vibr77/AppleIISDiskII_stm32f401/photo_screen/processed-6421B9E4-818E-487C-A50D-6F0CE80E2289.jpeg

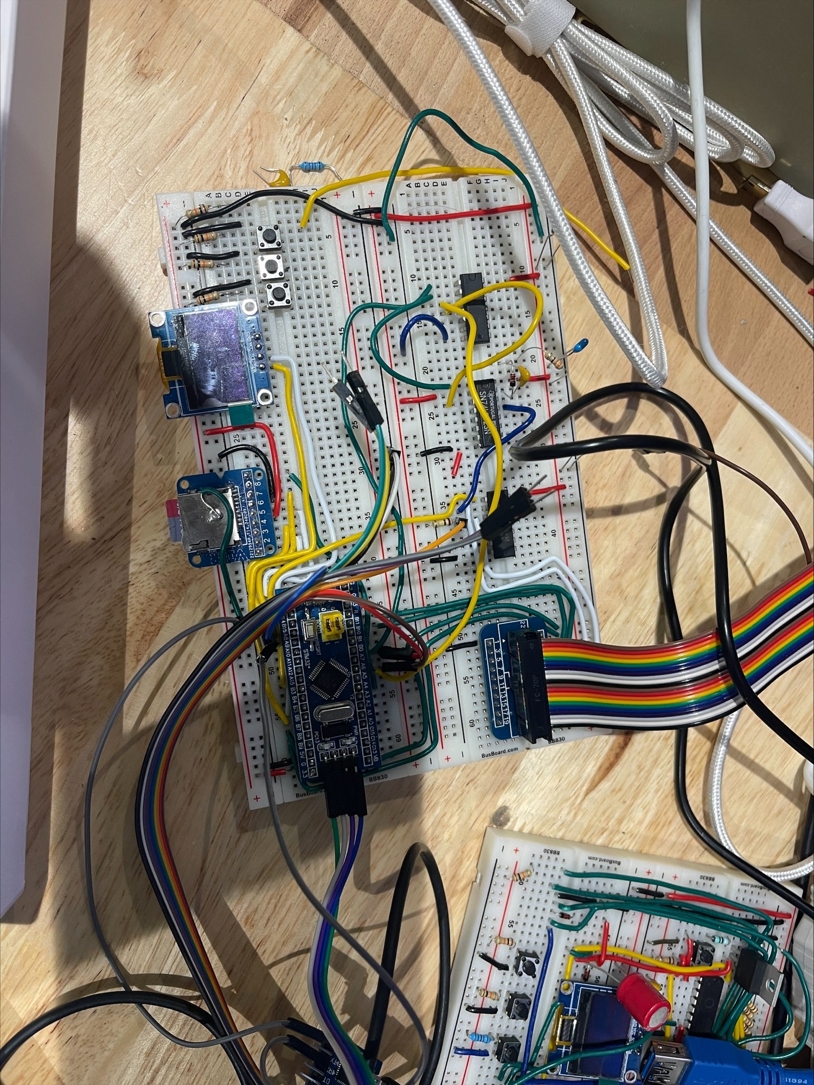
photo_screen/processed-6421B9E4-818E-487C-A50D-6F0CE80E2289.jpeg
