vibr77/AppleIISDiskII_stm32f401/photo_screen/processed-DC6E5C40-3600-4D25-BB47-7D1686A29BE4.jpeg

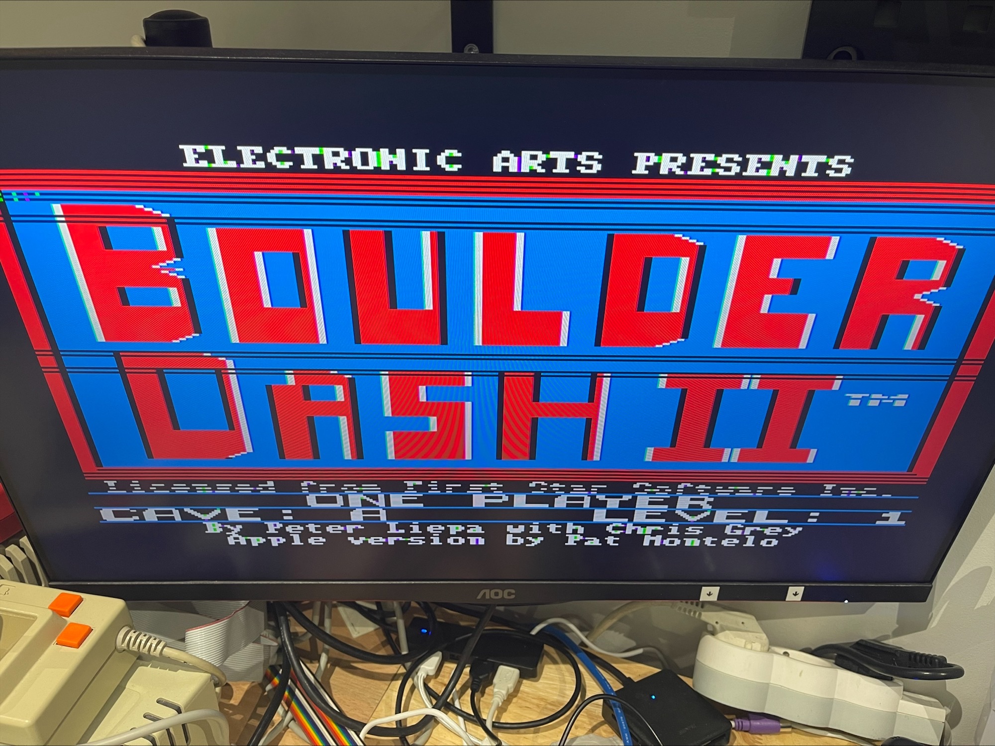
photo_screen/processed-DC6E5C40-3600-4D25-BB47-7D1686A29BE4.jpeg
