vibr77/AppleIISDiskII_stm32f401/screenshot/IMG_6480 Large.jpeg

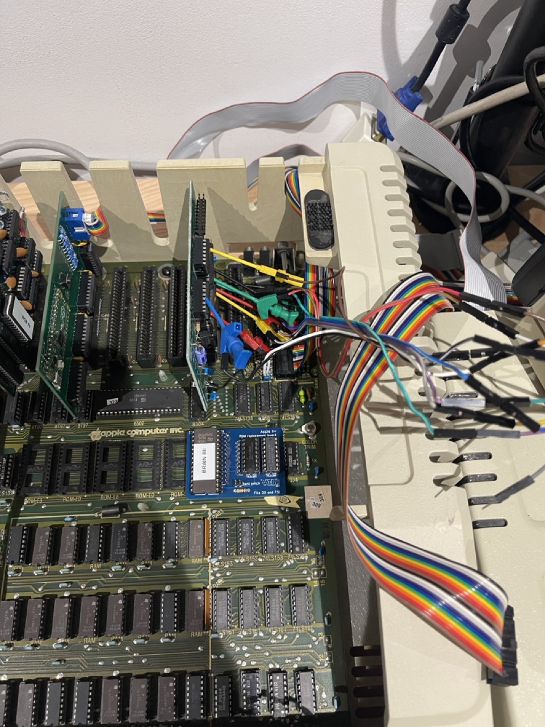
screenshot/IMG_6480 Large.jpeg
