vibr77/AppleIISDiskII_stm32f401/hardware/sdiskII_stm32.kicad_sch

## KiCad design hardware/sdiskII_stm32.kicad_sch (2024-07-04)

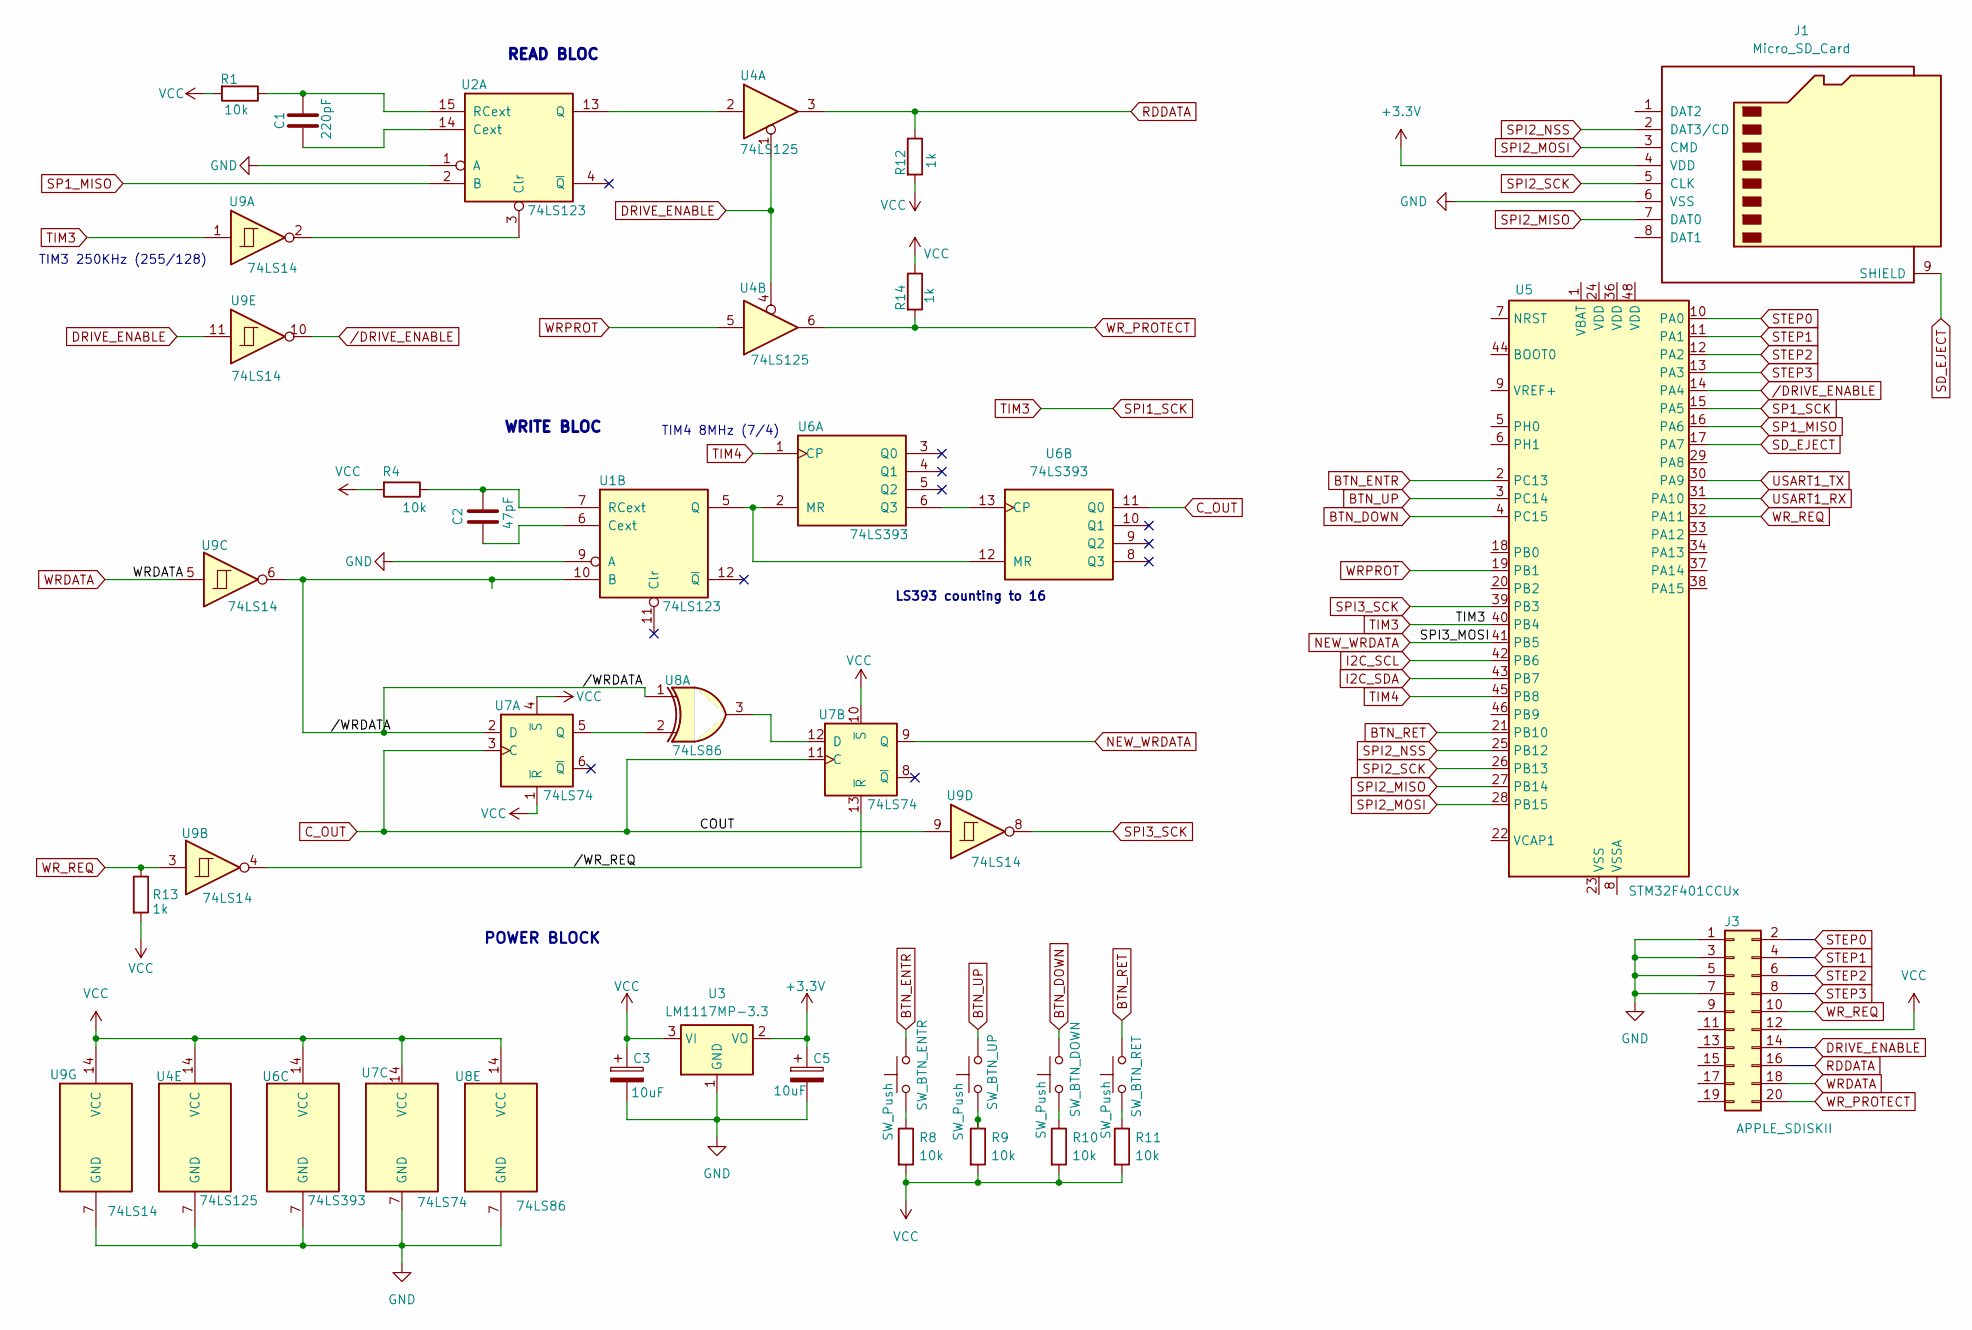
[picture p5: schematic sdiskII_stm32.kicad_sch]

Parts:
C1: 220pF
C2: 47pF
C3, C5: 10uF
J1: Micro_SD_Card
J3: APPLE_SDISKII
R1, R4, R8, R9, R10, R11: 10k
R12, R13, R14: 1k
SW_BTN_DOWN: SW_Push
SW_BTN_ENTR: SW_Push
SW_BTN_RET: SW_Push
SW_BTN_UP: SW_Push
U1, U2: 74LS123
U3: LM1117MP-3.3; SOT-223-3_TabPin2
U4: 74LS125
U5: STM32F401CCUx; QFN-48-1EP_7x7mm_P0.5mm_EP5.6x5.6mm
U6: 74LS393
U7: 74LS74
U8: 74LS86
U9: 74LS14

Connections:
+3.3V: C5.1, J1.4 (VDD), U3.2 (VO)
BTN_DOWN: SW_BTN_DOWN.2, U5.4 (PC15)
BTN_ENTR: SW_BTN_ENTR.2, U5.2 (PC13)
BTN_RET: SW_BTN_RET.2, U5.21 (PB10)
BTN_UP: SW_BTN_UP.2, U5.3 (PC14)
C_OUT: U6.11 (Q0), U7.3 (C), U7.11 (C), U9.9
DRIVE_ENABLE: U4.1, U4.4, U9.11
GND: C3.2, C5.2, J1.6 (VSS), J3.1, J3.3, J3.5, J3.7, U1.9 (A), U2.1 (A), U3.1 (GND), U4.7 (GND), U6.7 (GND), U7.7 (GND), U8.7 (GND), U9.7 (GND)
I2C_SCL: U5.42 (PB6)
I2C_SDA: U5.43 (PB7)
NEW_WRDATA: U5.41 (PB5), U7.9 (Q)
unnamed: C1.1, R1.1, U2.15 (RCext)
unnamed: C1.2, U2.14 (Cext)
unnamed: C2.1, U1.6 (Cext)
unnamed: C2.2, R4.1, U1.7 (RCext)
unnamed: R8.1, SW_BTN_ENTR.1
unnamed: R9.1, SW_BTN_UP.1
unnamed: R10.1, SW_BTN_DOWN.1
unnamed: R11.1, SW_BTN_RET.1
unnamed: U1.5 (Q), U6.2 (MR), U6.12 (MR)
unnamed: U2.3 (Clr), U9.2
unnamed: U2.13 (Q), U4.2
unnamed: U5.23 (VSS), U5.35 (VSS), U5.47 (VSS), U5.49 (VSS)
unnamed: U6.6 (Q3), U6.13 (CP)
unnamed: U7.5 (Q), U8.2
unnamed: U7.12 (D), U8.3
RDDATA: R12.1, U4.3
SD_EJECT: J1.9 (SHIELD), U5.17 (PA7)
SP1_MISO: U2.2 (B), U5.16 (PA6)
SP1_SCK: U5.15 (PA5)
SPI1_SCK: U5.40 (PB4), U9.1
SPI2_MISO: J1.7 (DAT0), U5.27 (PB14)
SPI2_MOSI: J1.3 (CMD), U5.28 (PB15)
SPI2_NSS: J1.2 (DAT3/CD), U5.25 (PB12)
SPI2_SCK: J1.5 (CLK), U5.26 (PB13)
SPI3_SCK: U5.39 (PB3), U9.8
STEP0: U5.10 (PA0)
STEP1: U5.11 (PA1)
STEP2: U5.12 (PA2)
STEP3: U5.13 (PA3)
TIM4: U5.45 (PB8), U6.1 (CP)
USART1_RX: U5.31 (PA10)
USART1_TX: U5.30 (PA9)
VCC: C3.1, J3.12, R1.2, R4.2, R8.2, R9.2, R10.2, R11.2, R12.2, R13.2, R14.1, U3.3 (VI), U4.14 (VCC), U6.14 (VCC), U7.1 (~R), U7.4 (~S), U7.10 (~S), U7.14 (VCC), U8.14 (VCC), U9.14 (VCC)
WRDATA: J3.18, U9.5
WRPROT: U4.5, U5.19 (PB1)
WR_PROTECT: J3.20, R14.2, U4.6
WR_REQ: J3.10, R13.1, U5.32 (PA11), U9.3
/DRIVE_ENABLE: U5.14 (PA4), U9.10
/WRDATA: U1.10 (B), U7.2 (D), U8.1, U9.6
/WR_REQ: U7.13 (~R), U9.4

Notes on the sheet:
READ BLOC
LS393 counting to 16
WRITE BLOC
POWER BLOCK
TIM3 250KHz (255/128)
TIM4 8MHz (7/4)
