vibr77/AppleIISDiskII_stm32f401/AppleIISDiskII_stm32f401.ioc

Mcu.UserName=STM32F401CCUx
PA0-WKUP.GPIO_Label=STEP0
PA0-WKUP.Signal=GPXTI0
PA1.GPIO_Label=STEP1
PA1.Signal=GPXTI1
PA10.Signal=USART1_RX
PA11.GPIO_Label=WR_REQ
PA11.Signal=GPXTI11
PA2.GPIO_Label=STEP2
PA2.Signal=GPXTI2
PA3.GPIO_Label=STEP3
PA3.Signal=GPXTI3
PA4.GPIO_Label=DEVICE_ENABLE
PA4.Signal=GPXTI4
PA5.Signal=SPI1_SCK
PA6.Signal=SPI1_MISO
PA7.GPIO_Label=SD_EJECT
PA7.Signal=GPXTI7
PA8.Signal=S_TIM1_CH1
PA9.Signal=USART1_TX
PB1.GPIO_Label=WR_PROTECT
PB1.Signal=GPIO_Output
PB10.GPIO_Label=BTN_RET
PB10.Signal=GPXTI10
PB12.Signal=SPI2_NSS
PB13.Signal=SPI2_SCK
PB14.Signal=SPI2_MISO
PB15.Signal=SPI2_MOSI
PB3.Signal=SPI3_SCK
PB4.Signal=S_TIM3_CH1
PB5.Signal=SPI3_MOSI
PB6.Signal=I2C1_SCL
PB7.Signal=I2C1_SDA
PB8.Signal=S_TIM4_CH3
PC13-ANTI_TAMP.GPIO_Label=BTN_ENTR
PC13-ANTI_TAMP.Signal=GPXTI13
PC14-OSC32_IN.GPIO_Label=BTN_UP
PC14-OSC32_IN.Signal=GPXTI14
PC15-OSC32_OUT.GPIO_Label=BTN_DOWN
PC15-OSC32_OUT.Signal=GPXTI15
