vibr77/AppleIISDiskII_stm32f401/Core/Inc/main.h

#define PUTCHAR_PROTOTYPE int __io_putchar(int ch)
#define PUTCHAR_PROTOTYPE int fputc(int ch, FILE *f)
#define BTN_ENTR_Pin GPIO_PIN_13
#define BTN_ENTR_GPIO_Port GPIOC
#define BTN_ENTR_EXTI_IRQn EXTI15_10_IRQn
#define BTN_UP_Pin GPIO_PIN_14
#define BTN_UP_GPIO_Port GPIOC
#define BTN_UP_EXTI_IRQn EXTI15_10_IRQn
#define BTN_DOWN_Pin GPIO_PIN_15
#define BTN_DOWN_GPIO_Port GPIOC
#define BTN_DOWN_EXTI_IRQn EXTI15_10_IRQn
#define STEP0_Pin GPIO_PIN_0
#define STEP0_GPIO_Port GPIOA
#define STEP0_EXTI_IRQn EXTI0_IRQn
#define STEP1_Pin GPIO_PIN_1
#define STEP1_GPIO_Port GPIOA
#define STEP1_EXTI_IRQn EXTI1_IRQn
#define STEP2_Pin GPIO_PIN_2
#define STEP2_GPIO_Port GPIOA
#define STEP2_EXTI_IRQn EXTI2_IRQn
#define STEP3_Pin GPIO_PIN_3
#define STEP3_GPIO_Port GPIOA
#define STEP3_EXTI_IRQn EXTI3_IRQn
#define DEVICE_ENABLE_Pin GPIO_PIN_4
#define DEVICE_ENABLE_GPIO_Port GPIOA
#define DEVICE_ENABLE_EXTI_IRQn EXTI4_IRQn
#define SD_EJECT_Pin GPIO_PIN_7
#define SD_EJECT_GPIO_Port GPIOA
#define SD_EJECT_EXTI_IRQn EXTI9_5_IRQn
#define WR_PROTECT_Pin GPIO_PIN_1
#define WR_PROTECT_GPIO_Port GPIOB
#define BTN_RET_Pin GPIO_PIN_10
#define BTN_RET_GPIO_Port GPIOB
#define BTN_RET_EXTI_IRQn EXTI15_10_IRQn
#define WR_REQ_Pin GPIO_PIN_11
#define WR_REQ_GPIO_Port GPIOA
#define WR_REQ_EXTI_IRQn EXTI15_10_IRQn
