vibr77/AppleIISDiskII_stm32f401/(commit log)

2024-06-21 start working on the write part, rearranging pin & spi
    [sdiskII_stm32.kicad_sch]
2024-06-23 Start working on write process, WR_REQ working, complete change of PIN, SPI with variable clock ...
    [sdiskII_stm32.kicad_sch]
2024-06-24 Write buffer DMA SPI fix, debugging writting process
    [main.c]
2024-06-24 last trace
2024-07-04 fix writing overlap, add log lib
    [sdiskII_stm32.kicad_sch]
