vibr77/AppleIISDiskII_stm32f401/screenshot/IMG_6478.jpeg

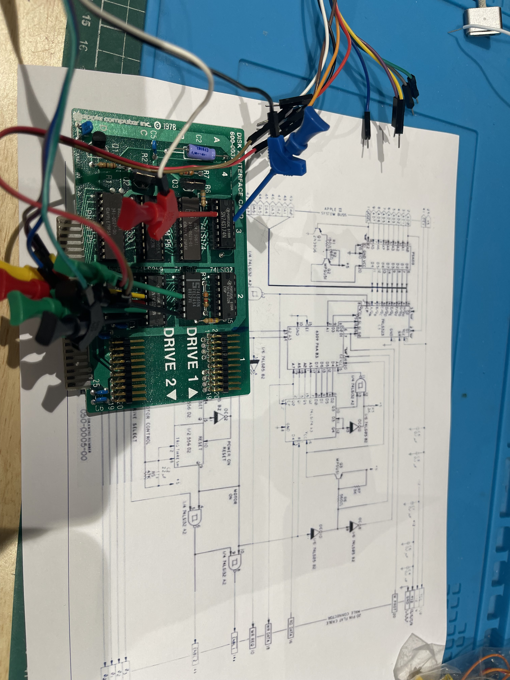
screenshot/IMG_6478.jpeg
